impatrq/stac/README.md

<div align="center">

(https://postimg.cc/9RRpcmtY)

</div>

## ¿Qué es STAC?
**STAC** es un sistema de detección de obstaculos implementado en un baston para ciegos con la finalidad de asistir en su recorrido.

## ¿Donde nacio la idea?
Luego de una investigación por parte del equipo productivo sobre las diferentes necesidades de las personas ciegas, concluimos en esta idea.

## Funcionamiento
El funcionamiento de **STAC** se basa en la utilización de un sensor ultrasonic que captara el obstaculo, luego procesando su localización, y evaluandola como una alerta vibratoria en el mango del baston.

## Reconocimientos
Agradecidos de ser ganadores del **1er Puesto** en la competencia **PROTOTIPOS I** de la ONIET celebrada por la Universidad Blas Pascal.
<div align="center">

(https://postimg.cc/HJvkmHBz)

</div>

**Contacto**
* Correo: stacproyect@gmail.com
* Youtube: https://www.youtube.com/watch?v=YbUuJB8ZXzU

**Equipo productivo:**

1. **Alfaro, Agustín**

    * Correo: agusalfaro128@gmai.com

    * Instagram: [alfaroaguss](https://www.instagram.com/alfaroaguss_/)

2. **Alba, Oriana**

    * Correo: oriialba8@gmail.com

    * Instagram: [_rebbbecaa](https://www.instagram.com/_rebbbecaa/)

3. **Balbi, Gabriel**

    * Correo: gabito.02@hotmail.com

    * Instagram: [gaby_balbi](https://www.instagram.com/gaby_balbi/)

4. **Cabrera, Nicolas**

    * Correo: nicocabreraaa@hotmail.com

    * Instagram: [nicoo_a.c](https://www.instagram.com/nicoo_a.c/)

5. **Torancio, Manuel**

    * Correo: manutorancio12@gmail.com

    * Instagram: [toranciom_](https://www.instagram.com/toranciom_/)
