impatrq/stac/Circuito del sensor/Especificaciones del motor.jpg

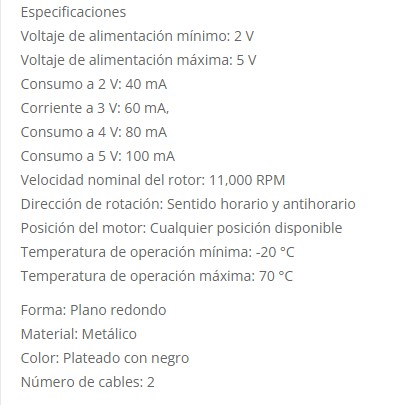
Circuito del sensor/Especificaciones del motor.jpg
