impatrq/stac/Modelado 3D/Imagen Modelado 3D.jpeg

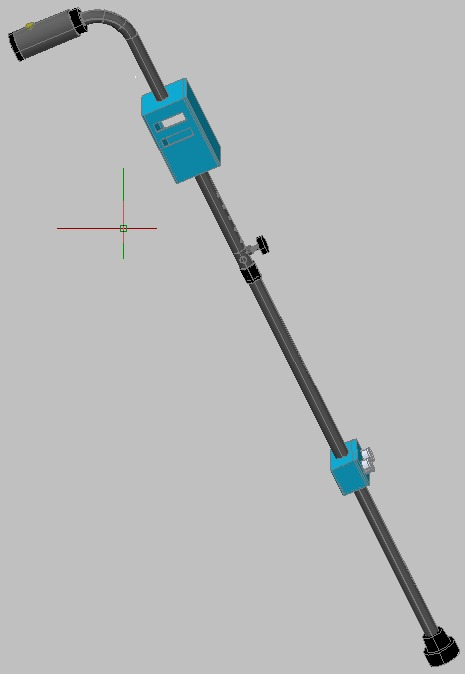
Modelado 3D/Imagen Modelado 3D.jpeg
