impatrq/stac/Presupuesto/administracion_de_presupuesto.xlsx

Adquirido | Cantidad | Componente | Link de referecia | Mejor precio | Por cantidad | Prestado? | Escuela? | Compra? | Proveedor | Observación
TRUE | 2 | Batería de litio de 3.7V | CLICK (https://www.todomicro.com.ar/investigacion-desarrollo-y-prototipado/1050-bateria-recargable-18650-2800mah.html) | $403.26 | $806.52 | FALSE | FALSE | TRUE | Todo micro | -
TRUE | 1 | Camara Pi | CLICK (https://tienda.starware.com.ar/producto/camara-modulo-raspberry-zero-cam-v13-5mp/) | $1109.00 | $1109.00 | FALSE | FALSE | TRUE | Starware | -
FALSE | 1 | Raspeberry Pi Zero | CLICK (https://articulo.mercadolibre.com.ar/MLA-686178962-raspberry-pi-zero-w-arm-512-mb-1-ghz-wifi-bluetooth-_JM) | $8197.00 | $8197.00 | TRUE | FALSE | FALSE |  | -
TRUE | 1 | Regulador 7805 | CLICK (https://articulo.mercadolibre.com.ar/MLA-875837997-regulador-7805cv-l7805cv-5v-15a-lm7805-_JM) | $65.00 | $65.00 | FALSE | TRUE | FALSE |  | -
TRUE | 1 | Filamento para 3D ABS | CLICK (https://articulo.mercadolibre.com.ar/MLA-832040214-filamento-para-impresoras-3d-abs-1kg-oferta-printalot-_JM) | $1780.00 | $1780.00 | FALSE | TRUE | FALSE | Mercado Libre | -
TRUE | 1 | ATMEGA328P | CLICK (https://articulo.mercadolibre.com.ar/MLA-918528788-atmega-328p-u-original-sin-bootloader-arduino-ptec-_JM) | $439.00 | $439.00 | FALSE | FALSE | TRUE |  | -
FALSE |  | Adaptador USB hembra | CLICK (https://www.prototiposdiy.com.ar/MLA-901463006-adaptador-usb-hembra-a-dip-pdiy--_JM) |  |  | FALSE | FALSE | FALSE | Prototipos Diy | -
TRUE | 3 | HC-sr04 | CLICK (https://www.todomicro.com.ar/arduino/81-sensor-ultrasonico-ultrasonido-hc-sr04-arduino-pic-robotica.html) | $161.00 | $483.00 | FALSE | FALSE | TRUE | Todo micro | -
TRUE | 3 | Motor vibrador | CLICK (https://candy-ho.com/producto/motor-vibrador-celular-redondo-10mm-x-2-5mm-3v-arduino/) | $114.10 | $342.30 | FALSE | FALSE | TRUE | Candy ho | -
TRUE | 1 | Cargador Bateria de litio | CLICK (https://www.todomicro.com.ar/investigacion-desarrollo-y-prototipado/708-modulo-de-carga-de-bateria-de-litio-con-entrada-micro-usb.html) | $190.00 | $190.00 | FALSE | FALSE | TRUE | Todo micro | -
TRUE | 1 | Capacitor 10μF | CLICK (https://articulo.mercadolibre.com.ar/MLA-670311298-capacitor-electrolitico-10uf-x-25v-micro-mini-4x5-pack-x100-_JM) | $7.30 | $7.30 | FALSE | TRUE | FALSE |  | -
TRUE | 1 | Diodo zener 5.1v | CLICK (https://articulo.mercadolibre.com.ar/MLA-863730672-20-unidades-diodo-zener-51v-12w-025w-51-volt-pack-x20-_JM) | $13.50 | $13.50 | FALSE | TRUE | FALSE |  | -
TRUE | 3 | Capacitor 0.1μF | CLICK (https://articulo.mercadolibre.com.ar/MLA-795403680-pack-x10-capacitor-ceramico-100nf-01uf-104-arduino-nubbeo-_JM) | $13.00 | $39.00 | FALSE | TRUE | FALSE |  | -
TRUE | 2 | Borneras | CLICK (https://articulo.mercadolibre.com.ar/MLA-705917848-pack-10-bornera-cable-2-borne-paso-508mm-nubbeo-_JM) | $30.00 | $60.00 | FALSE | TRUE | FALSE |  | -
TRUE | 1 | Disipador | CLICK (https://articulo.mercadolibre.com.ar/MLA-823927998-disipadores-raspberry-aluminio-kit-5u-para-pi-4-_JM) | $199.00 | $199.00 | FALSE | TRUE | FALSE |  | -
TRUE | 1 | Tarjeta de memoria SD | CLICK (https://www.mercadolibre.com.ar/tarjeta-de-memoria-sandisk-sdsqunb-032g-gn3ma-ultra-con-adaptador-sd-32gb/p/MLA14639668) | $770.00 | $770.00 | FALSE | FALSE | TRUE | Electronica | -
FALSE | 1 | - | CLICK | $0.00 | $0.00 | FALSE | FALSE | FALSE | - | -
FALSE | 1 | - | CLICK | $0.00 | $0.00 | FALSE | FALSE | FALSE | - | -
FALSE | 1 | - | CLICK | $0.00 | $0.00 | FALSE | FALSE | FALSE | - | -
FALSE | 1 | - | CLICK | $0.00 | $0.00 | FALSE | FALSE | FALSE | - | -
FALSE | 1 | - | CLICK | $0.00 | $0.00 | FALSE | FALSE | FALSE | - | -
FALSE | 1 | - | CLICK | $0.00 | $0.00 | FALSE | FALSE | FALSE | - | -
FALSE | 1 | - | CLICK | $0.00 | $0.00 | FALSE | FALSE | FALSE | - | -
FALSE | 1 | - | CLICK | $0.00 | $0.00 | FALSE | FALSE | FALSE | - | -
FALSE | 1 | - | CLICK | $0.00 | $0.00 | FALSE | FALSE | FALSE | - | -
FALSE | 1 | - | CLICK | $0.00 | $0.00 | FALSE | FALSE | FALSE | - | -
FALSE | 1 | - | CLICK | $0.00 | $0.00 | FALSE | FALSE | FALSE | - | -
FALSE | 1 | - | CLICK | $0.00 | $0.00 | FALSE | FALSE | FALSE | - | -
FALSE | 1 | - | CLICK | $0.00 | $0.00 | FALSE | FALSE | FALSE | - | -
