impatrq/stac/(list of files, cad)

Other CAD files:
Modelado 3D/stac.dwg
