impatrq/stac/(list of files, drawings)

Other design files:
Circuito del regulador/regulador_5v_1.pdsprj
Circuito del sensor/atmega_cristal.pdsprj
