impatrq/stac/(commit log)

2021-12-13 Modelados 3D
    En este se encuentran la version del baston e 3D y sus modificaciones.
    [stac.dwg]
2021-12-13 Subir circuito sensor
    [atmega_cristal.pdsprj]
2021-12-13 Create atmega con sensor
2021-12-13 chore: agregar circuito del sensor
    [atmega_cristal.pdsprj]
2021-12-13 chore:Agregar circuito del sensor
    [atmega_cristal.pdsprj]
2021-12-13 fix: arreglar imagen de reconocimiento ONIET
2021-12-13 Create Pcb y esquema
2021-12-13 docs: agregar codigo del sensor en lenguaje c
2021-12-13 chore: Agregar circuito del regulador de 5v
    [regulador_5v_1.pdsprj]
2021-12-14 chore: agregar carpeta de simulacion
2021-12-14 chore: agregar carpeta de simuacion del sensor
2021-12-14 docs: crear carpeta de carpeta tecnica
2021-12-14 docs: agregar carpeta de simulacion
2021-12-14 docs: Agregar manual de usuario
2021-12-14 docs: agregar pdf de Carpeta Tecnica
2021-12-14 style: agregar imagen de simulacion
2021-12-14 style: agregar imagen de simulacion del sensor
2021-12-14 style: agregar imagen de la simulacion de sensor
2021-12-14 docs: Agregar hoja de datos
2021-12-14 docs: Agregar datasheet del regulador de voltaje
2021-12-14 docs: crear carpeta de Carpeta de Campo
2021-12-14 docs: agregar word de Carpeta de Campo
2021-12-14 docs: Agregar carpeta de presupuesto
2021-12-14 docs: Agregar especificaciones del motor
2021-12-14 docs: agregar archivo de la lista de presupuesto
    [administracion_de_presupuesto.xlsx]
2021-12-14 docs: agregar .dwg del modelado 3D
    Archivo de Autocad
    [stac.dwg]
